mpskex/chisel-npu/docs/handoff-2026-08-10.md

# Handoff — silicon session-capture diagnosis & boundary-pulse fix (2026-08-10)

**EVENING UPDATE (root cause #1 FOUND + FIXED + SILICON-VALIDATED; 3-mma
still open).**  The "silicon keep=0" story from the morning is DEAD — it was
an artifact (see §7): the trajectory ctrl map was never in the bitstream
(firtool DCE + 5-bit wrapper truncation).  The REAL contamination was the
**mma_last VX[0] feed** (§8): the session terminator is dispatched as a data
feed with vs1=vs2=0, silently injecting stale VX[0] into the PEs on silicon
(sim stays clean because VX[0] resets to 0).  Fixed by forcing in_a=in_b=0
on mma_last; 30/30 one-shot clean on silicon, `test_one_shot_session`
de-xfailed.  The 3-mma test remains xfailed (§9: feed spacing across cache
lines).

Supersedes the open item in `handoff-2026-08-09.md` §6 (the 2 silicon xfails:
`test_one_shot_session`, `test_session_captures_columns`).  This session ran a
full diagnosis of the silicon-only session-capture contamination, found the
collector/keep divergence, implemented a self-timed boundary pulse, and
rebuilt a bitstream.  **The fix is NOT yet validated on silicon — the 
instrumented trajectory on the fresh bitstream still reads keep=0; this must
be re-checked (probe16's entry[15] decode is wrong; the stale-synth trap is
real and was hit twice).**

## 1. Status summary

| Item | State |
|:-----|:---|
| Netlist audit (top.sv vs Scala) | ✅ faithful on all 4 checkpoints |
| Host diagnosis (probes p1..p16) | ✅ done — contamination characterized |
| Sim reproduction attempts | ❌ sim is clean at every L3 latency (1..128) |
| Fast-path (frontend mma 1-tick) | ❌ implemented then **reverted** (made one-shot worse) |
| Root cause (proposed) | ⚠️ silicon `ctrl.keep=0` for the whole session vs sim `keep=1` — collector cnt frozen at 0 |
| Boundary-pulse fix (engine) | ✅ implemented, 98/98 sbt green, bitstream built |
| Silicon validation of the fix | ❌ **NOT DONE** — the last trajectory read still showed keep=0 |
| Critical gotcha found | ✅ `rerun_impl_engine.tcl` reuses STALE synth DCPs — several "fix" bitstreams never contained the new RTL |

---

## 2. The contamination (all confirmed by probes)

- Operands (A/B) are correct in the RF at feed time on silicon (probe p9).
- The sim (engine harness, frontend harness, latency-swept RAM) is clean at
  every L3 read latency 1..128 (NpuProgramEngineTimingSpec).
- The contamination is deterministic per absolute issue phase; clean phases
  are a minority and shift between builds/bitstreams.
- Dirty captures have the form `g[i] = a[i]·s + R[i]` with per-lane residue
  waves and the 3-mma captures being "two-column sums"
  `g[i] = a_m[i]·(b[c]+b[c+1]) + 7k`.

### The key sim-vs-silicon divergence (trajectory instrumentation)

Collector `{keep, dat_clct, cnt}` frozen 16-tick window (ctrl 0x20/0x24/0x28/0x2C):

| signal (session window) | SIM | SILICON |
|:---|:---|:---|
| `ctrl.keep` | 1 (accumulate) | **0** (overwrite) |
| collector `dat_clct` | HIGH | **LOW** |
| collector `cnt` | counting 1..15,0 | **0** (frozen) |

With `keep=0` the PEs run `res := in_a·in_b` (overwrite) and the collector's
`dat_clct` never opens, so the cnt stays 0 and the captured column is an
anti-diagonal/phase-dependent read.  The sim's keep=1 (with a single 1-tick
boundary pulse) is what produces clean uniform columns.

### Cautions before trusting the keep=0 reading
- `probe16.py` decodes entry[15] as `0x2C & 0x3F` — that is the **pad**, not
  the trajectory (must be `(0x2C >> 26) & 0x3F`).  The keep=0 conclusion
  rests on entries[0..14], which ARE correctly decoded — but re-verify on a
  known-good bitstream.
- The keep bit is only meaningful on the **6-bit** trajectory build.  All
  bitstreams loaded before the 11:02 full build were built from the stale
  Aug-9-20:40 synth (5-bit trajectory) — see §4.  The "keep=0" reads on those
  were reading the 5-bit dc bit into the "keep" field (artifact).

---

## 3. Changes made this session

### `src/main/scala/engine/npuProgramEngine.scala` — boundary-pulse fix
Replaced the clct-dependent boundary (`lastCapturePending` +
`boundaryPending` set on `mmalu.io.clct && lastCapturePending`) with a
**self-timed engine-local one-tick pulse**:

```scala
val boundaryCnt   = RegInit(0.U(6.W))
val boundaryPulse = RegInit(false.B)
when (mmaFeed && dec.mma_last) { boundaryCnt := (2 * K).U }
when (boundaryCnt =/= 0.U)     { boundaryCnt := boundaryCnt - 1.U }
when (boundaryCnt === 1.U)     { boundaryPulse := true.B }
when (boundaryPulse)           { boundaryPulse := false.B }
...
mmalu.io.ctrl.keep      := !boundaryPulse
```

Rationale: the boundary (keep=0 PE reset) must last exactly one tick, fired
2K ticks after the mma.last feed (after its clct/capture write).  It no
longer depends on the MMALU clct/keep interaction suspected on silicon.

### Debug instrumentation (kept, needed for validation)
- `dataCollector.scala` / `mma.scala`: `dbg_cnt` (collector phase) and
  `dbg_dat_clct` outputs.
- `npuProgramEngine.scala`: 16-deep `{keep, dat_clct, cnt}` trajectory,
  frozen at the boundary pulse into `trajSnap`.
- `npuFrontend.scala` ctrl map: 0x20/0x24/0x28/0x2C (6-bit entries ×5/reg;
  0x2C = `{traj(15), 27'b0}` → traj(15) at bits [31:26]).
- Keep 0x18 = clct, 0x1C = mma_acc (unchanged).

### Reverted
- The frontend mma fast-path (`npuFrontend.scala`) — consecutive 1-tick mma
  issue made the one-shot *worse* on silicon (issue phases landed dirty);
  the pre-fast-path timing gave 12/12 clean on one +0.042 build.  Do not
  resurrect without the phase-alignment understanding.

### New test/probe files (untracked)
- `src/test/scala/engine/NpuProgramEngineTimingSpec.scala` — latency-swept
  RAM (LatencyRamModel) one-shot classification; clean at all latencies.
- `src/test/scala/engine/NpuProgramEngineTrajSpec.scala` — sim trajectory
  comparison (sim: keep=1, dc=H, cnt counting; sim snapshot KH1..KH15,KH0).
- `src/test/scala/alu/mma/MMALUDcProbeSpec.scala` — raw MMALU keep=1 probe
  (dc=HIGH, cnt counting, uniform columns).
- `tool/hw/session_diag.py` — host probes p1..p6 (classify captures, VX
  dumps, disjoint-vd).
- `tool/hw/probe7..probe16.py` on the FPGA host (`~/probe*.py`) — phase
  scans, feed-time operand dumps, trajectory readback.
- `ip/vivado/xc7k480t/scripts/set_fabric_165.tcl` — 165 MHz MMCM (did NOT
  help; contamination persisted).

### sbt status
98/98 tests pass (96 pre-existing + TimingSpec + TrajSpec + DcProbeSpec).
`make build` regenerates top.sv (verified: emitted boundaryPulse/boundaryCnt
logic is correct).

---

## 4. CRITICAL gotchas learned

### `rerun_impl_engine.tcl` reuses STALE synth DCPs
`run_impl_and_write_bit` reuses `synth_1/top_wrapper.dcp` and the OOC
`top_npu_engine_subsys_0_synth_1/*.dcp`.  After any RTL change you MUST either
- run the **full** `scripts/build_npu_engine.tcl` (synth + impl), or
- `rm -f proj/npu_migrate.runs/synth_1/top_wrapper.dcp
  proj/npu_migrate.runs/top_npu_engine_subsys_0_synth_1/*.dcp` before the
  rerun.

All reruns since Aug 9 20:40 (the fast-path "builds" at ~06:06, the k6 build,
and the first boundary-pulse "build") shipped the Aug-9-20:40 logic.  The
bitstream that actually contains the boundary fix is the full build at
**Aug 10 11:02**.  Verify synth freshness by comparing the DCP timestamps with
`top.sv` (this session's fresh synth: top-level 09:51, subsys OOC 09:44).

### FPGA host bring-up (after a reboot)
Warm reboot does not always re-enumerate PCIe.  Flow that worked:
`tool/hw/program_bitstream.sh ip/vivado/xc7k480t/top_npu_engine.bit` →
warm reboot → wait for ssh → `sudo lspci -nn | grep 10ee` (expect
`01:00.0 ... [10ee:7028]`) → `sudo rmmod xdma; cd
~/dma_ip_drivers/XDMA/linux-kernel/xdma && sudo insmod xdma.ko` →
`ls /dev/xdma0_bypass`.  If the device is missing, re-JTAG-load and reboot
(the FCH PCIe enumeration is flaky; never power off the host).

---

## 5. Next steps (priority order)

1. **Fix `probe16.py` entry[15] decode** (`(0x2C >> 26) & 0x3F`) and
   re-probe the **11:02 bitstream** (currently loaded).  The current
   keep=0 reading needs confirmation on a known-6-bit build; if keep is
   really 0 despite the counter pulse, the divergence is elsewhere
   (e.g., the MMALU's `ctrl.keep` input path, or the trajectory's keep
   bit wiring) — go to the ILA.
2. If keep=1 on silicon: run `session_diag.py 1 4` and `pytest tests -m hw`.
   If the captures become uniform columns → remove the 2 xfails, update
   `fake_native.py`/docs, and add the trajectory/keep assertions to the
   hw tests.
3. If still dirty: build `top_npu_with_ila`-style ILA on `ctrl.keep`,
   `clct`, `dat_clct`, `cnt`, and the collector buffer contents during a
   live session (the u_npu_ila flow in the test-hw-xc7k480t skill).
4. Revert the debug instrumentation (trajectory regs) and remove the probe
   specs from the test suite once the fix is proven.

## 6. Files to revisit when the fix lands
- `drivers/chisel_npu_py/tests/test_program_engine.py` — remove the two
  `@pytest.mark.xfail` markers.
- `docs/handoff-2026-08-09.md` — supersede §6.
- The 5-bit→6-bit trajectory layout change touches nothing in the driver
  (the probe scripts read the raw ctrl offsets), but the final tree should
  drop the instrumentation.

---

## 7. The "silicon keep=0" story was an artifact (evening session)

- The trajectory ctrl map (0x20..0x2C) was **never in any bitstream**: firtool
  DCE'd it because `io.ctrl_addr` was `UInt(5.W)` — `ctrl_addr === 0x20.U` is
  provably false for a zero-extended 5-bit input → branches + ports pruned.
  Repro'd with `make build` + grep (no `5'h20` in the mux).
- Second layer: `npu_engine_subsys.v` declared `wire [4:0] ctrl_addr` —
  truncating the 7-bit ctrl_lite output → Vivado DCE'd the map in OOC synth
  (verified via DCP dump: 0 trajSnap cells).
- probe16.py's reads were **aliased**: 0x20/0x24/0x28/0x2C mapped to
  CTRL/FRAMES/STATUS/ERR_INFO (5-bit masking) — the "keep=0, dc=L, cnt=0"
  was STATUS/pc bits, and "entry[14]=kL11..15 counting" was `pc>>2`.
- Fixed: `npuFrontend.scala` ctrl_addr → `UInt(7.W)`; `npu_engine_ctrl_lite.v`
  + `npu_engine_subsys.v` → 7-bit ctrl_addr; 0x28/0x2C branches made exactly
  32 bits (0x28 had a 38-bit Cat that truncated traj(10); 0x2C a 33-bit Cat
  that dropped the keep bit).  Add `dbg_clct` passthrough on the frontend.
- `NpuProgramEngineFrontendSpec` now asserts the ctrl 0x20..0x2C trajectory
  readback (keep=1, dc=H, cnt = full 0..15 rotation) — guards the DCE trap.
- On the rebuilt bitstream the trajectory reads **sim-like**: keep=1, dc=H,
  cnt counting, for every probe16 run.  Engine-side control is correct.

## 8. Root cause #1 (FIXED + silicon-validated): the mma_last VX[0] feed

- `mma_last` (vs1=vs2=0) is dispatched by the engine as a **data feed** —
  `in_a = VX[vs1] = VX[0]`, `in_b = VX[vs2] = VX[0]`.  Sim only stays clean
  because VX[0] resets to 0.  On silicon VX[0] holds stale data (any earlier
  program that loaded VX[0], e.g. `test_illegal_instruction_halts`'s
  `vle8(0, ...)`), so every capture gets `VX0[i]·VX0[c]` added — the
  observed per-lane residue waves / phase-dependent contamination.
- Proven on silicon (probe19): VX[0]=zeros → 5/5 PURE; VX[0]=0x7F → 4/5
  captures exactly `+V0[i]·V0[c]`; ramp/all2/0x55 → residue present
  (phase-dependent).
- **Fix** (`npuProgramEngine.scala`): `in_a/in_b := Mux(mmaFeed && !dec.mma_last,
  VX[...], 0)` — mma_last is a terminator marker, feeds zeros (parallel to
  the existing vs3==0 accum zero-forcing).  Comment updated.
- Regression: `NpuProgramEnginePhaseSweepSpec` — 24-phase one-shot sweep
  (asserts all clean) + a VX[0]-loaded contamination test (asserts clean;
  verified it FAILS without the fix).
- Silicon validation: probe16 12/12 clean, probe19 25/25 PURE, exact-test
  probe 30/30 clean, `pytest -m hw` 6 passed / 1 xfailed (3× stable).
- `test_one_shot_session`: xfail marker REMOVED.

## 9. OPEN ITEM (next session): the 3-mma session (`test_session_captures_columns`)

- Still xfailed.  Silicon: mma0 capture = feed0-only / full-sum (phase/run
  dependent), mma1/mma2 = partial sums `a0·b0[c]+a1·b1[c]` — the feeds are
  gapped by **cache-line misses** (the 4 mma words straddle lines 1-2;
  DDR fills ≈ 200 ticks).
- The sim with 40-NOP gaps between the mma feeds **reproduces** the partial
  captures (NpuProgramEnginePhaseSweepSpec tooling / SimInstrProbeSpec —
  scratch spec removed); the sim with 3-tick spacing is clean (full-sum
  columns 5,8,11).
- Software alignment probe (pad=6, all 4 mma words in one line) → 5/6 clean
  (probe21), but 7/20 with the exact test (probe22) — not reliable.  pad=2
  (prefetched line) → deterministic garbage — prefetch path suspect.
- Candidate fixes: (a) ILA on feed ticks/clct/cnt/collector during a live
  3-mma session (definitive); (b) frontend prefetch so mma lines are present
  before the session (note the firtool cache-invalidate bug comment in
  npuFrontend.scala); (c) retest the frontend mma fast-path — all prior
  fast-path "silicon results" came from STALE bitstreams (never real).

## 10. Build/bring-up notes (this evening)

- Bitstreams built this session (both fresh synth, `build_npu_engine.tcl`,
  WNS +0.007 / -0.072 (the -0.072 is a benign MIG temp-monitor endpoint on
  userclk1, not the 165 MHz engine fabric)).
- hw_server: `$HOME/Vivado/2025.2/Vivado/bin/hw_server` (started manually;
  xsdb connect URL is `TCP:localhost:3121`, NOT `tcp:127.0.0.1`).
- `program_bitstream.sh` needs `XSDB=$HOME/Vivado/.../xsdb` (script defaults
  to `$HOME/Xilinx/...`).
- Probe scripts live on the host (`~/chisel_npu_py/probe*.py`); `deploy.sh`
  wipes them — re-copy from the dev host (`/tmp/opencode/probe*.py`).
