mpskex/chisel-npu/docs/designs/02.memory.md

# [WIP] Memory

!!! warning "Aspirational — not implemented"
    This is an early design note.  The `.reg.ax/bx/cx/dx` / `.sreg` register
    classes, the SPM, and the `TBD` address table below are **not** in the
    codebase.  The implemented memory path is the program engine's single
    `NpuDmaEngine` AXI master plus the `NpuSections` map in
    `engine/npuProgramEngine.scala` (`DATA_BASE = 0x4000_0000`: sections
    A/B/ACCUM/OUT; `CODE_BASE = 0x4000_4000`).

Memory design is always a big issue for NPU architectures as SIMD and SIMT always have a high memory wall between the processing unit and the memory devices. Our implementation is seeking a integrated SoC solution so we assume that the we are sharing L2 caches (which boosts DMA DDR access) and having a large scratch pad memory (SPM) to save the intermediate results.

We are referring some of the designs in [NVIDIA PTX ISA](https://docs.nvidia.com/cuda/parallel-thread-execution/index.html#state-spaces-types-and-variables). And as we are designing a slave device for the CPU so the architecture will be Harvard-ish.

## Memory Address Layout

|Name|Address|Internal Access|External Access|Comment|
|:----|----:|:----:|:----:|:----|
|.reg|TBD|R/W|R/W|Per Processing Core|
|.sreg|TBD|RO (R/W only by CU)|RO|All Cores|
|.code|TBD|R/W|R/W|Per Processing Core|
|.code.kernel|TBD|RO|R/W (only by bios?)|Kernel Library Code|
|.data|TBD|R/W|R/W|Per Processing Core|
|.sdata|TBD|R/W|R/W|Global|

### Registers

|Name|Address|Bitwidth|Comment|
|:----|----:|:----:|:----|
|Registers|====|====|====|
|.reg.ax|TBD|32|Vector register AX per Processing Core|
|.reg.bx|TBD|32|Vector register BX per Processing Core|
|.reg.cx|TBD|32|Vector register CX per Processing Core|
|.reg.dx|TBD|32|Vector register DX per Processing Core|
|Shared Registers|====|====|====|
|.sreg.fl|TBD|32|flag register for CU|
|.sreg.pc|TBD|32|program pointer|

## Memory Barriers on SW & HW

Here are some good references to this topic:
1. [Breaking Down Barriers: An Intro to GPU Synchronization](https://gpuopen.com/gdc-presentations/2019/gdc-2019-agtd5-breaking-down-barriers.pdf)
2. This is also helpful for parallel computing: [An Intro to GPU Architecture and Programming Models](https://www.youtube.com/watch?v=lGmPy8xpT4E&t=6109s)
