mpskex/chisel-npu/(commit log)

2024-10-13 update arm docker
2026-05-22 [Draft] Fangrui/xc7k480t bring up (#14)
    * fpga(xc7k480t): timing closure — per-lane DataFeeder + 200 MHz fabric clock
    Three compounding fixes that together achieve formal timing closure
    (WNS = +0.003 ns, 0 failing endpoints) for the K=32 MMALU on
    xc7k480tffg1156-2 at 200 MHz fabric / 250 MHz PCIe.
    ## DataFeeder per-lane buffer_accum (src/main/scala/alu/mma/sa/dataFeeder.scala)
    The original Pipe(Vec(n, SInt(accum_nbits.W)), 2*n-1) generated a single
    shared valid register (_v_reg) with fanout=1025 (n=32 lanes × 2n-1=63
    pipeline stages). Vivado placed this FF in the centre of the die with
    7.9 ns of net delay against an 8 ns two-cycle MCP budget → WNS=-0.782 ns.
    Replace with n individu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
    [IO_Port.xdc, bringup_flash.py, npu_ctrl_lite.v, npu_dma_master.v, npu_subsys.v, serial_console.py]
2026-08-05 chisel_npu_py: Python userspace NPU driver over XDMA + docs + skill (#15)
    * chisel_npu_py: Python userspace NPU driver over XDMA + docs + skill
    New pip package drivers/chisel_npu_py with a pybind11 boundary:
    - NativeXDMA (native.cpp) owns fds, DDR addresses, register offsets and
    DMA transfers; Python only moves buffers (numpy/bytes/bytearray).
    - numpy-first API: ChiselNPU.mmalu(A,B,ACCUM[,OUT]) stage->kick->wait->
    collect; XDMADevice raw DMA + typed reads; CtrlLite done/busy protocol.
    - C++ enforces alignment, 4 GB DDR window, and the MMALU staging table
    (name + byte-size checked); mmap'd bypass BAR for ctrl_lite regs.
    - Tests: 25 unit (injectable FakeNative, no HW) + 14 hardware test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
2026-10-15 Fangrui/refine dispatch frontend (#17)
    * fix(engine): reject out-of-range operands; retire NONE slots; explicit memWidth
    * test(engine): pin legacy R-format mma as engine-illegal
    * feat(isa): InstrTable attribute-exempt + mma.last helpers
    * refactor(isa): InstrDecoder exemptions from InstrTable
    * refactor(isa): disassembler attrOK from InstrTable
    * refactor(engine): frontend shares InstrTable.isMmaLastWord
    * docs(engine): engine controls mma keep via boundary gate
    * docs: correct top-level K and fix dispatch table row
    * chore: address final-review cosmetic nits (import, comment, K note)
    * docs(skills): record verified Vivado 2025.2 install path; drop stale ~/Xilinx refs
    * docs: add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
2026-11-14 Fangrui/refine dispatch frontend (#18)
    * docs: spec for MACs/cycle benchmarking, dispatch optimization, K=32/W=16 vu9p bring-up
    * docs: implementation plan for engine MACs/cycle benchmark (Phase 0-1)
    * feat(engine): per-session cycle/MAC counters + benchmark helpers
    * feat(engine): expose cycle/MAC counters via ctrl_lite 0x40/0x44
    * test(engine): throughput matrix A1/B1/B2
    * test(engine): report A1 feed-phase rate (exclude drain) in throughput matrix
    * test(engine): throughput matrix B3/B4/B5
    * test(engine): C1 frontend throughput (fetch/decode overhead)
    * docs: Phase 1 benchmark results (K=32/W=16, 100%→~1% peak)
    * fix(engine): latch perf counters at done; de-tautologize A1
    * te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
